PolyCortex/AcquisitionEEG/Documentation/Software/Data storage/subFunctions/blPlot/kakearney-boundedline-pkg-50f7e4b/Inpaint_nans/monet_adresse.jpg

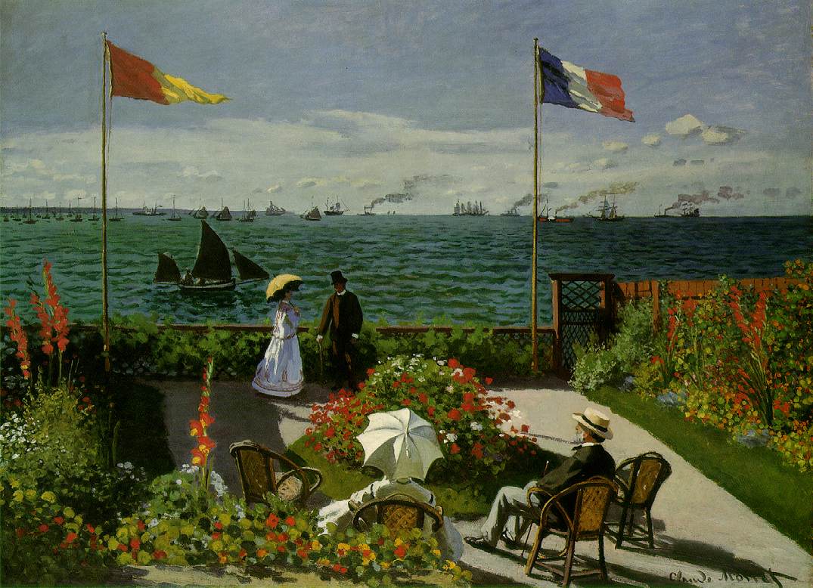
Documentation/Software/Data storage/subFunctions/blPlot/kakearney-boundedline-pkg-50f7e4b/Inpaint_nans/monet_adresse.jpg
