PolyCortex/AcquisitionEEG/Documentation/Software/Data storage/subFunctions/blPlot/kakearney-boundedline-pkg-50f7e4b/Inpaint_nans/garden50.jpg

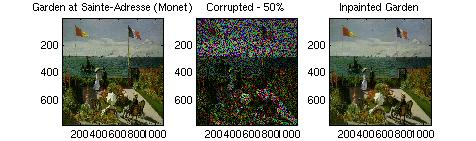
Documentation/Software/Data storage/subFunctions/blPlot/kakearney-boundedline-pkg-50f7e4b/Inpaint_nans/garden50.jpg
