PolyCortex/AcquisitionEEG/Documentation/Software/Data storage/CloseOpen(uVSquaredPerHz).png

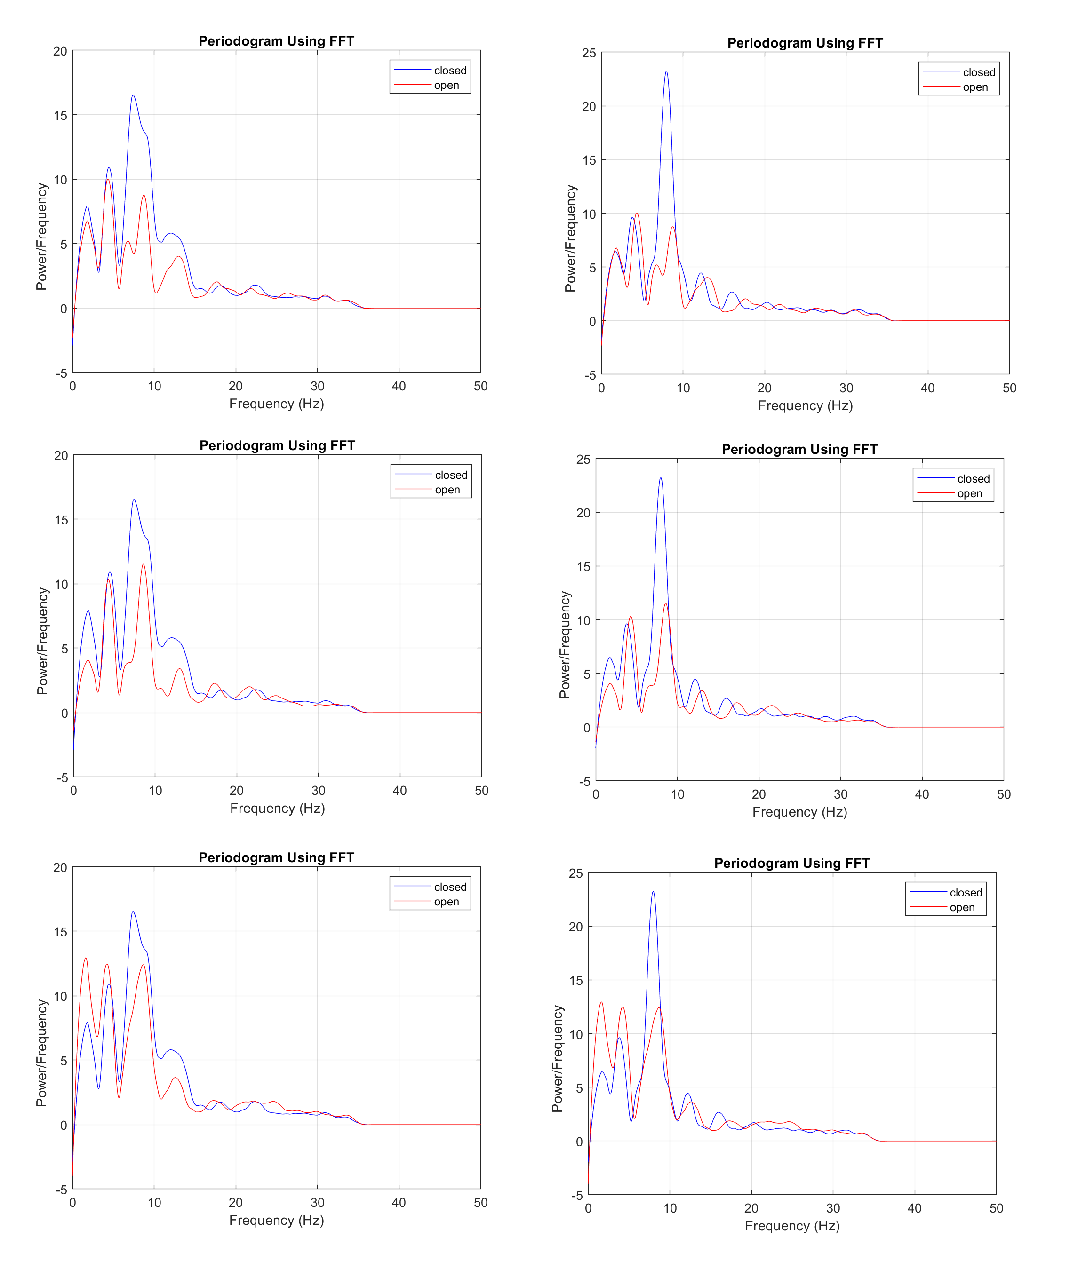
Documentation/Software/Data storage/CloseOpen(uVSquaredPerHz).png
