PolyCortex/AcquisitionEEG/Documentation/Software/Data storage/subFunctions/blPlot/kakearney-boundedline-pkg-50f7e4b/Inpaint_nans/demo/html/inpaint_nans_demo_02.png

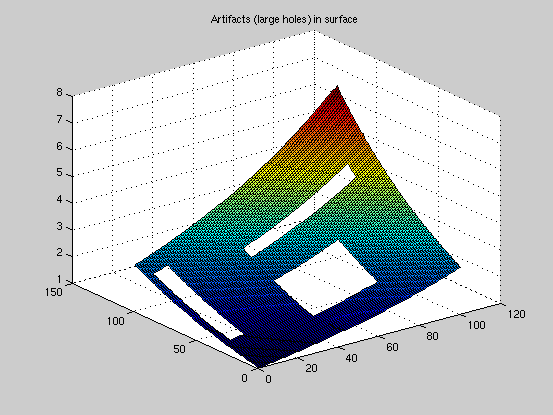
Documentation/Software/Data storage/subFunctions/blPlot/kakearney-boundedline-pkg-50f7e4b/Inpaint_nans/demo/html/inpaint_nans_demo_02.png
