PolyCortex/AcquisitionEEG/Documentation/components list - Prototype PCB.xlsx

Component | Value or model | Quantity
ADC | ADS122C04 | 1
Capacitor | 0.1u | 43
Capacitor | 1u | 6
Capacitor | 10u | 9
Capacitor | 0.12u | 4
Capacitor | 2.2u | 4
Capacitor | 0.022u | 2
Capacitor | 100u | 1
Capacitor | 4.7u | 6
Capacitor | 0.47u | 1
Capacitor | 5pF | 1
Common mode choke | CM4732V301R-10 | 1
CON | Male | 14
DCDC Converter | LMZ12002TZ | 1
DCDC Converter | LT3483IS6 | 1
Diode | PMEG3002AEB | 1
Inductance | 4.7uH | 1
Inductance | Ferrite-200 | 2
Instrumentation amp | AD8422 | 4
Operational amp | LM324 | 10
Potentiometer | P160KN2 | 1
Protection | TPD4E1B06DCKR | 2
Resistor | 26.7k | 8
Resistor | 3.4k | 16
Resistor | 250 | 8
Resistor | 37.4k | 4
Resistor | 75k | 4
Resistor | 60.4k | 4
Resistor | 20k | 8
Resistor | 10k | 9
Resistor | 5k | 8
Resistor | 40k | 4
Resistor | 1k | 4
Resistor | 32.4k | 2
Resistor | 2.5k | 1
Resistor | 11.8k | 1
Resistor | 2.1k | 1
Resistor | 250k | 1
Resistor | 10 | 1
RF Filter | EMI103T-RC | 6
Supply battery | 9V | 1
TOTAL |  | 207
