PolyCortex/AcquisitionEEG/Documentation/components list - Secondary PCB.xlsx

Componant | Value or Model | Quantity
ADC | ADS7828 | 1
Capacitor | 0.12u | 4
Capacitor | 0.1u | 31
Capacitor | 10u | 8
Capacitor | 1u | 5
Capacitor | 2.2u | 4
CON | Male | 22
Instrumentation amp | AD8422 | 4
Operational amp | LM324 | 5
Protection | TPD4E1B06DCKR | 1
Resistor | 10k | 4
Resistor | 20k | 8
Resistor | 2k | 2
Resistor | 3.4k | 8
Resistor | 37.4k | 4
Resistor | 400k | 4
Resistor | 5 | 1
Resistor | 50 | 4
Resistor | 5k | 8
Resistor | 60.4k | 4
Resistor | 75k | 4
Supply | 9V | 2
Total | - | 138
