PolyCortex/AcquisitionEEG/Documentation/LTspice/1channel.asc

C1: cap; 10µ
C2: cap; 10µ
C3: cap; 1µ
C4: cap; 0.1µ
C5: cap; 93n
C6: cap; 3µ
C7: cap; 1µ
C8: cap; 0.1µ
R1: res; 37.4k
R2: res; 138k
R3: res; 37.4k
R4: res; 37.4k
R5: res; 37.4k
R6: res; 75k
R7: res; 75k
R8: res; 37.4k
R9: res; 75k
R10: res; 26.7k
R11: res; 3.4k
R12: res; 3.4k
R13: res; 60.4k
R14: res; 26.7k
R15: res; 3.4k
R16: res; 10k
R17: res; 20k
R18: res; 20k
R19: res; 5k
R20: res; 5k
R21: res; 40k
R22: res; 7.4k
R26: res; 60
R27: res; 3.4k
R28: res; 60.4k
R29: res; 26.7k
R30: res; 3.4k
U1: UniversalOpamp2
U2: UniversalOpamp2
U3: UniversalOpamp2
U4: UniversalOpamp2
U5: UniversalOpamp2
U6: UniversalOpamp2
U7: UniversalOpamp2
U8: UniversalOpamp2
U9: UniversalOpamp2
U10: UniversalOpamp2
U12: AD8429
U13: UniversalOpamp2
V1: voltage; 100
V2: voltage; 100
V3: voltage; 100
V4: voltage; 100
V5: voltage; 100
V6: voltage; 100
V7: voltage; 100
V8: voltage; 100
V9: voltage; 100
V10: voltage; 100
V11: voltage; 100
V12: voltage; 100
V13: voltage; 100
V14: voltage; 100
V15: voltage; 100
V16: voltage; 100
V17: voltage; 100
V18: voltage; 100
V19: voltage; 100
V20: voltage; 100
V26: voltage; 100
V27: voltage; 100
V28: voltage; SINE(0 50u 10 0 0 0 1000)
V29: voltage; 100
V30: voltage; 100
V31: voltage; ""; AC 1 0
Named nets: 0
.tran 0 0.7 0.1
Passe-haut avec fréquence de coupure de 0.3Hz
Passe-bas avec fréquence de coupure de 35Hz
Notch avec fréquences de coupures de
Amplification de gain 12,76
60Hz
ancien circuit ampli op
nouvel ampli op
Notch avec fréquences de coupures de
60Hz
