PolyCortex/AcquisitionEEG/Documentation/LTspice/Simulation notch.asc

C1: cap; 94n
C2: cap; 3µ
C3: cap; 93n
C4: cap; 3µ
R1: res; 20k
R2: res; 10k
R3: res; 20k
R4: res; 5k
R5: res; 5k
R6: res; 20k
R7: res; 10k
R8: res; 20k
R9: res; 5k
R10: res; 5k
U1: UniversalOpamp2
U2: UniversalOpamp2
U3: UniversalOpamp2
U4: UniversalOpamp2
V1: signal; AC 1
V2: voltage; 9
V3: voltage; 9
V4: voltage; 9
V5: voltage; 9
V6: signal; AC 1
Named nets: 0
.ac dec 100 1 200
;ac dec 100 1 200
notch idéal avec c=93n et c=3u
close enough notch avec les valeurs dispo sur
digikey, soit c=94n et c=3u
