PolyCortex/AcquisitionEEG/(list of files, drawings)

Other design files:
Documentation/DipTrace/ADC/ADC_layout.dip
Documentation/DipTrace/ADC/ADC_schematic.dch
Documentation/DipTrace/notch/notch_layout.dip
Documentation/DipTrace/notch/notch_schematic.dch
Documentation/DipTrace/v2.2/v2.2_layout.dip
Documentation/DipTrace/v2.2/v2.2_schematic.dch
Documentation/DipTrace/v3.0/v3.0_layout.dip
Documentation/DipTrace/v3.0/v3.0_schematic.dch
