PolyCortex/AcquisitionEEG/(commit log)

2019-01-22 Added Right leg driver, TODO: check retroaction, add DC-DC converter
    [Schematic 1.1.dch, test.dch, test2.dch, test3.dch]
2019-01-23 Added input filtering+CMC
    [Schematic 1.1.dch]
2019-01-25 deleted followers Aops
    [Schematic 1.1.dch]
2019-01-25 vol de librairie
2019-01-25 ADC changed, DC-DC 2V5 TODO: RLD, generer -2V5 , RLD, LDO, filtres alim
    [Schematic 1.1.dch]
2019-01-26 Schematics done, TODO: attach pattern, simulate, verify
    [Schematic 1.1.dch]
2019-01-30 footprintt assigned, bom generated, VERIFY GND-VCC-(protec2), change wiring CMC for routing
    [Schematic 1.1.dch, pcbFixedChallenge2019.dip]
2019-01-30 with bom
    [bom.xlsx]
2019-01-31 Placement started
    [Schematic 1.1.dch, pcbFixedChallenge2019.dip]
2019-01-31 Cleaned ratlines
    [Schematic 1.1.dch, pcbFixedChallenge2019.dip]
2019-02-01 Placement in progress
    [Schematic 1.1.dch, bom.csv, bom.xlsx, pcbFixedChallenge2019.dip]
2019-02-04 Placement done, starting routing
    [Schematic 1.1.dch, bom.csv, bom.xlsx, pcbFixedChallenge2019.dip]
2019-02-04 save fail
    [pcbFixedChallenge2019.dip]
2019-02-06 Routing done, ADC corrected
    TODO: add thermal pads, triple-check
    [Schematic 1.1.dch, pcbFixedChallenge2019.dip]
2019-02-07 stash to test autorouting
    [Schematic 1.1.dch, bom.csv, bom.xlsx, pcbFixedChallenge2019.dip]
2019-02-12 Ajout d'un dossier de documentation
    [Components.xlsx, Components_Fixed.xlsx]
2019-02-12 Started a doc of circuit details
2019-03-18 continued doc
    [list of comp.xlsx]
2019-03-18 continued doc, cleaned component list **left to do : steps to reproduce, testing section, révision
    [Components_Fixed.xlsx, Stats of components.xlsx, list of comp.xlsx]
2019-03-18 added datasheet folder
    [List of Components.xlsx]
2019-03-29 Updated doc with info from the new card
    [List of Components - Main PCB.xlsx, List of Components - Secondary PCB.xlsx, List of Components.xlsx, Stats of components.xlsx, stats of Components - Secondary PCB.xlsx]
2019-04-13 Edited text
    [List of Components - Prototype PCB.xlsx]
2019-04-14 Completed doc
    added limitations, and ADC code
2019-04-14 File structuring and minor modifications
    [ADC_layout.dip, ADC_schematic.dch, Components.xlsx, Stats of components.xlsx, bom.csv, bom.xlsx, close1.csv, components list - Prototype PCB.xlsx]
2019-04-14 Files structuring and minor modifications
    [ADC_layout.dip, ADC_schematic.dch, Components.xlsx, Stats of components.xlsx, bom.csv, bom.xlsx, close1.csv, components list - Prototype PCB.xlsx]
